ese5160/a14g-final-submission-s25-t21-pixel-circuit/final-project-t21-pixel-circuit/A11G_README.md

# A11G Board Bringup

```
Team Number:
Team Name:
Team Members:
GitHub Repository URL:
Description of test hardware: (development boards, sensors, actuators, laptop + OS, etc)
```
