ese5160/a14g-final-submission-s25-t21-pixel-circuit/final-project-t21-pixel-circuit/Application/src/firmware/Tools/gain_builder/gain_sheets/atwinc1500_mr210pa_gain_setting.csv

ch | 1 | 2 | 3 | 4 | 5 | 6 | 7 | 8 | 9 | 10 | 11 | 12 | 13 | 14
1 | -11 | -11 | -11 | -11 | -11 | -11 | -11 | -11 | -11 | -11 | -11 | -11 | -11 | -11
2 | -11 | -11 | -11 | -11 | -11 | -11 | -11 | -11 | -11 | -11 | -11 | -11 | -11 | -11
5.5 | -10 | -10 | -10 | -10 | -10 | -10 | -10 | -10 | -10 | -10 | -10 | -10 | -10 | -10
11 | -10 | -10 | -10 | -10 | -10 | -10 | -10 | -10 | -10 | -10 | -10 | -10 | -10 | -10
6 | -10 | -6 | -6 | -6 | -6 | -6 | -6 | -6 | -6 | -6 | -6 | -6 | -6 | -8
9 | -10 | -6 | -6 | -6 | -6 | -6 | -6 | -6 | -6 | -6 | -6 | -6 | -6 | -8
12 | -10 | -6 | -6 | -6 | -6 | -6 | -6 | -6 | -6 | -6 | -6 | -6 | -6 | -8
18 | -10 | -6 | -6 | -6 | -6 | -6 | -6 | -6 | -6 | -6 | -6 | -6 | -6 | -8
24 | -10 | -6 | -6 | -6 | -6 | -6 | -6 | -6 | -6 | -6 | -6 | -6 | -6 | -8
36 | -10 | -8 | -8 | -8 | -8 | -8 | -8 | -8 | -8 | -8 | -8 | -8 | -8 | -8
48 | -10 | -10 | -10 | -10 | -10 | -10 | -10 | -10 | -10 | -10 | -10 | -10 | -10 | -10
54 | -10 | -10 | -10 | -10 | -10 | -10 | -10 | -10 | -10 | -10 | -10 | -10 | -10 | -10
MCS0 | -10 | -6 | -6 | -6 | -6 | -6 | -6 | -6 | -6 | -6 | -6 | -6 | -6 | -8
MCS1 | -10 | -6 | -6 | -6 | -6 | -6 | -6 | -6 | -6 | -6 | -6 | -6 | -6 | -8
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
